csater1026-rgb/siliconSpyder/enclosure-preview.png

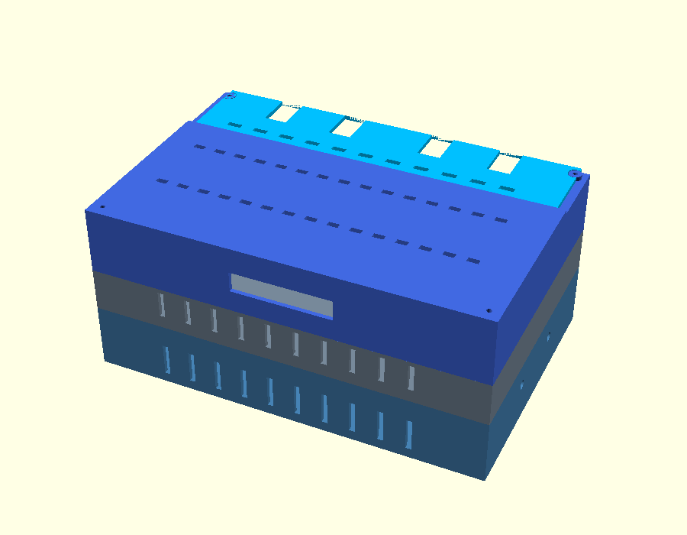
enclosure-preview.png
