csater1026-rgb/siliconSpyder/(commit log)

2026-08-21 Add technician and customer/vendor dashboards
    Silicon Spyder Live (technician view) and Spyder Protection (customer/
    vendor view), rebuilt from the project brief spec: dark/blue themed live
    threat feed with severity-coded alert cards and stats tiles, and a
    mobile-first protected/threat status page with plain-English attack
    explanations, sound/vibration/notification alerts, and a daily threat
    counter. Both poll the get_alerts Supabase RPC every 3s and fall back to
    a self-contained demo mode with simulated attacks when no device
    credentials are configured. Connection settings (Supabase URL/anon key,
    device ID/key) are entered via an in-page settings panel and stored only
    in that browser's loca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
2026-08-21 Add landing page linking to both dashboards
    Claude-Session: https://claude.ai/code/session_01TzMqryDgVxAzZLWVmmmSye
2026-08-21 Add Secure WiFi Box build guide, link from landing page
    Full phased build plan for turning the Spyder into a combined secure
    event-WiFi + usage-metering + threat-detection appliance: architecture,
    bill of materials, physical wiring, enclosure diagram, software stack,
    and build phases 0-5 with exact commands (cellular WAN, NAT/DHCP
    routing, vnstat metering + Supabase ingest_usage RPC, running detection
    alongside routing, portability/fail-open notes), plus risks and a
    pre-event testing checklist.
    The device-key example in the usage_push.py snippet is redacted to a
    placeholder -- same reasoning as the dashboards, since this repo is now
    public.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
2026-08-21 Add parametric enclosure (.scad), link + preview from landing page
    silicon-spyder-enclosure.scad models the 3-tier case from the project
    brief as four separate printable parts (base/chamber/tray/cover,
    selected via the `part` variable):
    - base: closed, vented electronics tier. Pi4 standoffs on the real
    58x49mm M2.5 hole pattern, SMA panel-mount holes (6.5mm) on the short
    end walls for the cellular/GNSS and Alfa monitor-adapter antennas,
    and hex nut traps under each corner post.
    - chamber: cooling tier, vented on both long walls, open top/bottom,
    with a solid shelf carrying the 2x 40mm fan cutouts (32mm hole
    pattern, 38mm bore).
    - tray: router cradle -- solid walls hug the AX21's l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
    [silicon-spyder-enclosure.scad]
2026-08-21 Rework enclosure to base/chamber/top, verified antenna count per part
    Restructures the enclosure from 4 pieces (base/chamber/tray/cover) to 3,
    matching how the hardware actually splits: base (bottom) holds
    everything except the fans and the router, chamber (middle) holds the
    2 fans, top holds the TP-Link router as a single liftable piece
    (cradle walls + vented lid merged into one part) instead of two
    separately-stacked pieces.
    Verified antenna count against the real hardware instead of assuming:
    - Raspberry Pi 4: 0 (onboard PCB antenna, no external connector)
    - SIM7600G-H HAT: 2 ship in the box (LTE MAIN + GPS/GNSS), confirmed
    via the product listing's package contents. Board has a 3rd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
    [silicon-spyder-enclosure.scad]
2026-08-21 Split the router top into a fixed cradle+lid and a detachable rear hatch
    Splits the single-piece router top into two parts instead of one:
    - top_fixed: cradle walls (full depth) + the front ~70% of the lid,
    screwed down through all 4 corner posts same as base/chamber. Not
    meant to come off routinely.
    - top_hatch: a separate panel covering the rear ~30% -- exactly where
    the AX21's antennas AND its port cluster (WAN/LAN/power) actually
    are, since those sit on the router's rear face, not its top. Rests
    loose on top of top_fixed's cradle walls (no screws), so it lifts
    off by hand any time you need to plug/unplug the router or route a
    cable down the rear cable chase to the base, wi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
    [silicon-spyder-enclosure.scad]
2026-08-22 Add visual step-by-step guide for installing the 4G HAT
    New page (4g-hat-install.html), linked from the landing page: mounting
    and powering on the SIM7600G-H on a Pi 4, with real inline-SVG diagrams
    for the three places a picture beats prose -- GPIO pin-1 alignment,
    the HAT's MAIN/GNSS/AUX antenna connector layout (AUX left unpopulated
    to match the base enclosure's spare SMA hole), and the PWRKEY-press ->
    wait -> NET-LED-blink power-on sequence -- plus the raspi-config serial
    setup and lsusb/minicom/AT verification steps as code blocks. Scoped
    deliberately to what doesn't need a SIM card, with a closing note
    pointing at the build guide's Phase 1 for the part that does.
    Reuses the existing d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
2026-08-22 Add a full overhead Pi 4 diagram to the HAT install guide
    The pin-1 alignment figure was an abstract rectangle-with-dots -- it
    didn't help identify the real board. Added a proper overhead diagram
    first, showing the actual Pi 4 port layout (verified against real
    board specs, not assumed): GPIO header along the top edge with pin 1
    at the left end, USB-C power + micro-HDMI x2 + audio jack along the
    bottom, and Ethernet + USB 3.0 x2 + USB 2.0 x2 along the right. Calls
    out which USB 2.0 port already has the Alfa adapter and which free one
    the HAT's cable goes into, plus a note that the microSD slot is on the
    underside. The existing pin-alignment mounting diagram stays right
    after it as the zoomed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
